LautaroEst/2016_2c_trabajo_practico-lector_de_qr/README.md

Repositorio para la documentación de proyectos de
6609/8607 Laboratorio de Microcontroladores

ESCANEO Y DECODIFICACIÓN DE UN CÓDIGO QR

En el presente proyecto se diseñará e implementará un dispositivo capaz de escanear una matriz QR impresa en una hoja de papel, decodificar el mensaje que se encuentra en ella y enviar los datos por bluetooth a un dispositivo celular. 

Integrantes: 

Estienne, Lautaro

Rebollo, Tomás
