LautaroEst/2016_2c_trabajo_practico-lector_de_qr/doc/informe/informe_corregido.pdf

# Facultad de Ingeniería - UBA Departamento de Electrónica 86.07/66.09 - Laboratorio de Microprocesadores

# Escaneo y Decodificación de Códigos QR

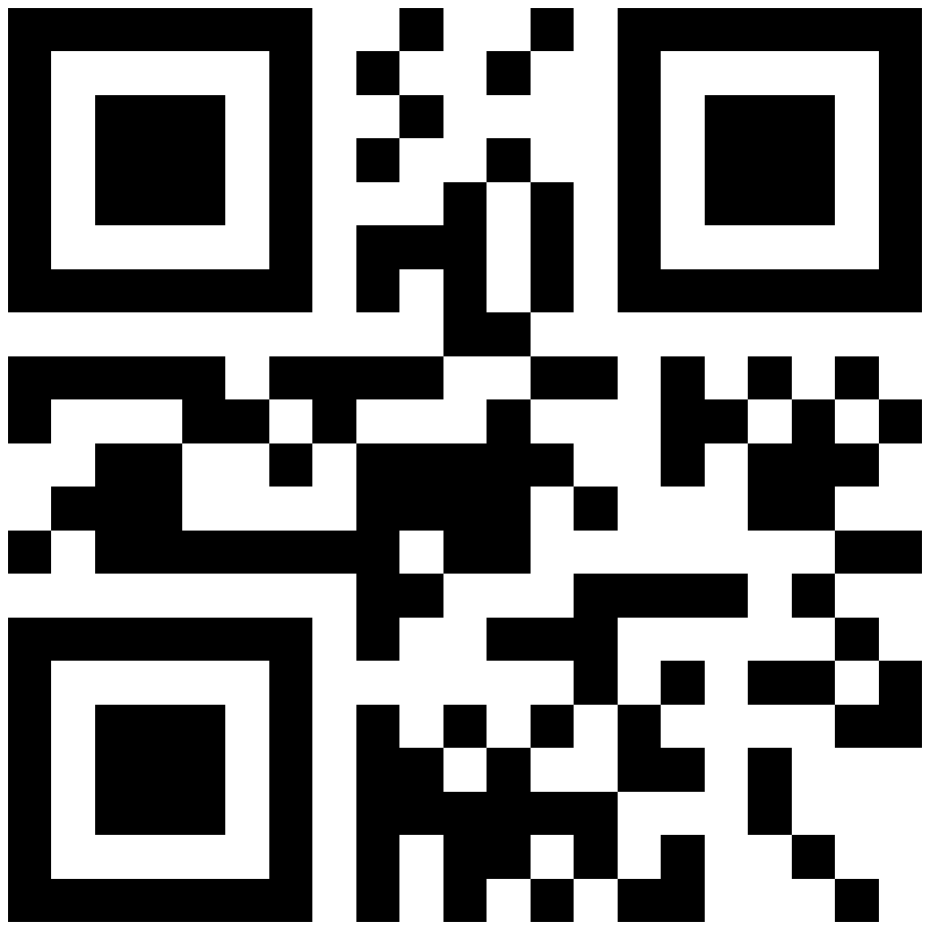
[picture p1: figure]

Profesor: | Ing. Guillermo Campiglio
Cuatrimestre/Año: | 2º/2016
Turno de las clases prácticas | Miércoles
Jefe de trabajos prácticos: | Ing. Ricardo Arias
Autores | Seguimiento del proyecto
Nombre | Apellido | Padrón
Lautaro | Estienne | 96671
Tomás | Rebollo | 90986

# Observaciones:

Fecha de aprobación | Firma J.T.P

# Coloquio Nota final Firma profesor

# 86.07/66.09 - Laboratorio de Microprocesadores do Cuatrimestre de 2016

# Estienne, Lautaro Rebollo, Tomás

# Resumen

En el presente trabajo, se construyó y programó un dispositivo capaz de escanear un código QR impreso en una hoja de papel, decodificarlo y enviar el mensaje contenido en él a un dispositivo celular. A su vez, el mismo fue diseñado para que el control de encendido y apagado del escaneo y el envío del mensaje sean controlados por Bluetooth.

# 1. Breve Introducción

Un código QR (Quick Response code, “código de respuesta rápida”) es un módulo para almacenar información

# en una matriz de puntos, que se utiliza hoy en día en distintas formas:

Registro de repuestos en el área de la fabricación de vehículos (primera implementación de estos códigos)

# Administración de inventarios en una gran variedad de industrias

# Almacenamiento de direcciones de páginas WEB en publicidades y anuncios

# Venta de productos y marketing de fidelización (como por ejemplo, cupones o descuentos)

# Etiquetado de productos en la tienda (como un código de barras)

La información que contiene un código QR puede incluír caracteres ACII, Kanji, o combinaciones de ambos, y además de los caracteres codificados, la matriz contiene una serie de puntos que dan información acerca de cómo está almacenado el mensaje en el código.

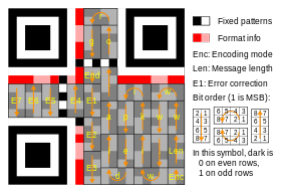
[picture p2: figure]

# Figura 1: Disposición de la información en la matriz QR

La decodificación del código consiste básicamente en dos pasos: leer y decodificar la información auxiliar de código para entender cómo está dispuesta la información, y luego leer la matriz en la forma en que está dispuesto el código (respetando la información obtenida anteriormente). En la figura 1 se muestra un código QR con el mensaje “www.wikipedia.org”, y en el mismo puede observarse qué parte del la matriz contiene la información del mensaje y qué parte contiene la información auxiliar (format info).

1

# 2. Objetivos Propuestos

La idea original del proyecto fue armar un dispositivo que permitiera escanear un código QR impreso en una hoja de papel, almacenar el mensaje contenido en él en la memoria temporal del microcontrolador, y finalmente, enviarlo a un dispositivo móvil por medio de una conexión bluetooth. También se decidió que el control de todo el proceso sea a través del mismo dispositivo.

# 3. Implementacion

Una vez propuestos los objetivos, se pasó a pensar en la forma de implementar el scanner. En primer lugar, el dispositivo debería contener un microcontrolador que se ocupe de sincronizar el proceso en su totalidad. Se sabe además que se debería constar de un sensor de luz para realizar el escaneo y a su vez, un motor que permita mover dicho sensor por la hoja. Por otro lado, la misma hoja debería ser desplazada por otro motor independiente del anterior. Por último, es necesario un circuito que se encargue de la transmisión por bluetooth (para lo cual ya existen módulos prefabricados).
Luego de algunas variantes se llegó a la versión final del dispositivo, mostrada en la figura 2:

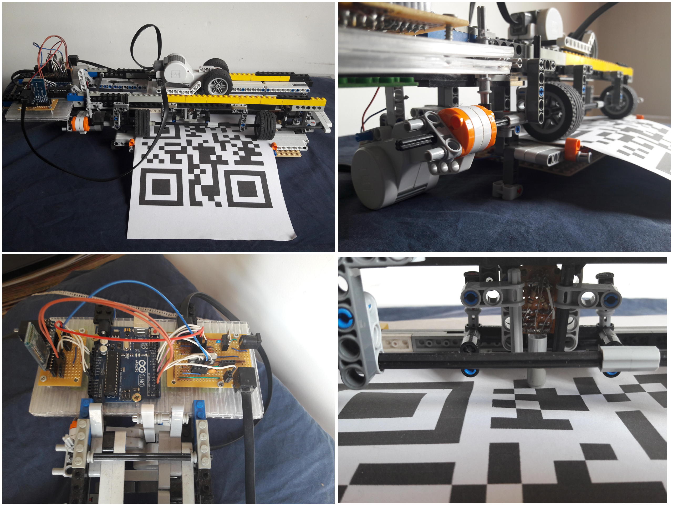
[picture p3: figure]

Figura 2: Fotografía del proyecto terminado.

2

Puede observase el código impreso en la hoja y los motores que controlan el rodillo que arrastra la hoja, y el carrito que mueve el sensor. A medida que la hoja avanza, el carrito hace recorrer al sensor por cada fila de la matriz. En cada barrido, se detectan los cambios de color y, con el dato de la posición del carrito, se calculan cuántos bits se leyeron de cada color. Como la matriz es un conjunto de puntos blancos y negros, entonces puede representarse como una serie de unos y ceros y almacenarse en la memoria temporal del micro. Una vez leído el código, el programa cargado en el microcontrolador decodifica el mensaje, almacenando en otra parte de memoria únicamente la sucesión de caracteres ASCII que componen el mensaje del código. Finalmente, el mensaje es transmitido al celular gracias al módulo bluetooth que se puede visualizar en la misma figura que antes.

Una vez pensada la forma en que el dispositivo trabajaría, se realizó el diagrama en bloques del circuito, el cual se muestra en la figura 3. Esto sirvió para definir los modelos de los materiales necesarios para el proyecto y posteriormente, la modularización del trabajo. En la siguiente sección se describe la lista de materiales y componentes utilizados en el circuito y en el resto del dispositivo.

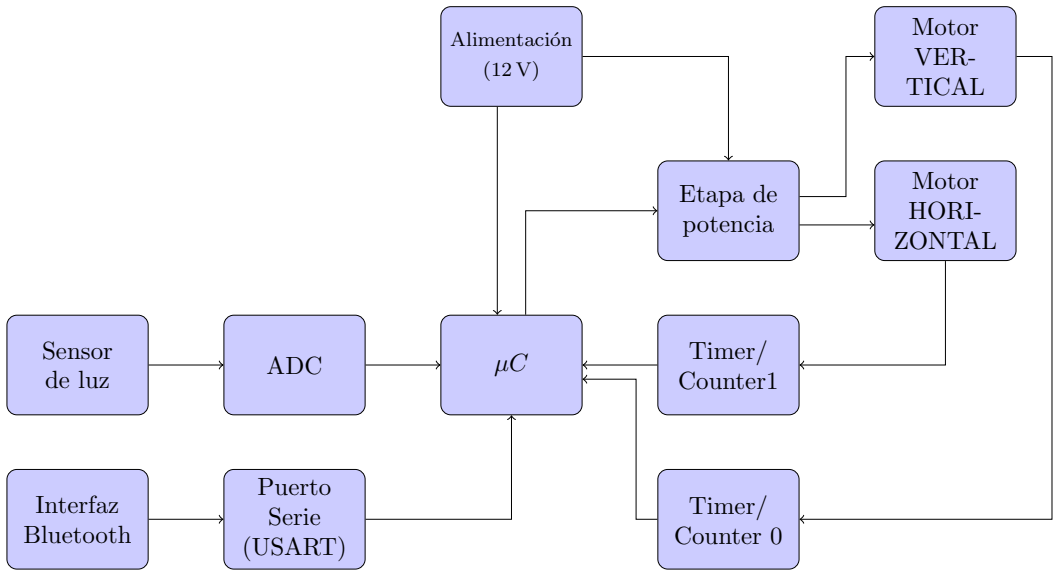
[picture p4: figure]
Alimentación; Motor VER- TICAL; Etapa de potencia; Motor HORI- ZONTAL; Sensor; de luz; ADC; Timer/; Counter1; Interfaz Bluetooth; Puerto Serie (USART); Timer/ Counter 0

Figura 3: Diagrama en bloques del circuito completo.

# 4. Descripción del Hardware

El circuito contiene una placa Arduino UNO, la cual utiliza un microcontrolador Atmega328P, que fue el implementado en este trabajo. En principio, la elección de este microcontrolador se debe fundamentalmente a la cantidad de memoria Flash y SRAM disponible, y esto es consecuencia de la gran dimensión de código que se necesitó para programar la decodificación del QR y la memoria necesaria para almacenar la matriz. Sin embargo, al finalizar el trabajo, puede comprobarse que si fuera por un tema de memoria, otros microcontroladores como el Atmega168 o el Atmega328 también habrían servido. Ahora bien, en el trabajo se utilizó la instrucción jmp para salto incondicional (debido nuevamente a la extensión del código) y esa instrucción sólo está permitida en el Atmega328P o en el Atmega168PA.
Por otro lado, se tiene el sensor de luz. El mismo fue construído específicamente para el trabajo y consiste en un circuito como el que se muestra en el esquemático del apéndice. En éste, se muestra un fotoresistor de Cadmio que varía su valor con la luz. De esta forma se obtiene una señal analogica que entra a uno de los puertos del micro y se

3

determina a partir de ella si el color que se está leyendo es blanco o negro. Para que el contraste entre un color y el otro sea mayor, se utilizó una tira de LEDs del otro lado del papel, de manera que llegue más luz a este último. Esta parte del trabajo fue, sin duda, la más crítica, ya que se debió preparar al equipo para que el escaneo soporte la resolución del código. Luego de varias pruebas se logró un resultado satisfactorio, con lo cual se concluyó que este sensor de fácil implementación sería suficiente para cubrir los objetivos del trabajo práctico.
Continuando con el circuito, se llega a la etapa de potencia utilizada para controlar los dos servo motores que controlan el escaneo. Estos motores funcionan correctamente con una tensión de 9 V, por lo que fue necesario adaptar la salida del microcontrolador con un puente-H doble (ya que se tienen dos motores). Para ello se eligió el integrado L298, uno de los más comunes para esta tarea. El circuito de esta etapa no comprende demasiadas complicaciones y se muestra en el apéndice del informe. Sí es posible agregar, sin embargo, que estos motores se comunican mendiante 6 conectores, descritos a continuación. Los primeros dos son la salida del puente-H: el motor avanza al aplicarle tensión positiva y retrocede con una tensión negativa; cuando no hay tensión, el motor se encuetra quieto. Existen por otro lado, otros dos pines destinados a la tensión de referencia del motor (VCC y GND). Finalmente, el motor cuenta con un encoder de dos terminales, el cual permite medir la velocidad con la que se mueve y la dirección en la que avanza. Para el trabajo sólo fue necesario uno de ellos, ya que sólo se midió la posición.
Por último, la interfaz del bluetooth no presenta mayores complicaciones, ya que el módulo utilizado (el HC-05 configurable como maestro-esclavo) tiene dos pines para la comunicación por puerto serie, y otros dos para la alimentación.
La construcción del dispositivo que permite sostener los motores, el sensor y el resto del circuito fue realizada mediante el equipo Mindstorms NXT 2.0 desarrollado por la empresa LEGO en 2006. El mismo viene equipado con los motores mencionados anteriormente y con todas las piezas necesarias para el armado del proyecto, excluyendo por supuesto, los componentes del circuito. La mayor parte de la información del funcionamiento de los motores fue obtenida de Wikipedia (ver referencia [6]) y de los diversos tutoriales encontrados en la web y dirigidos por personas que ya descubrieron el funcionamiento interno de los componentes.

# 5. Descripción del Software

La figura ?? muestra el diagrama de flujo del programa. Para una explicación más detallada, el código se

# encuentra dividido en 7 grandes bloques, a saber:

Inicialización y configuraciones: Dentro de este módulo se realizan todas las inicializaciones de variables y configuraciones a utilizar. Se utilizaron flags de estado y registros redefinidos con otros nombres para llevar

# más fácilmente el seguimiento del código. Las configuraciones realizadas fueron:

- Configuración de puertos como entradas y salidas.
- Configuración del ADC interno del microcontrolador.
- Configuración de timers como contadores.
- Configuración de USART como receptor de datos (el envío desde el microcontrolador será inicializado solo al momento en que se requiera enviar datos).
Una vez finalizadas las configuraciones, se realiza la primera lectura del ADC para saber en donde se encuentra actualmente el sensor.

Recepción Bluetooth: El programa quedará esperando la recepción de datos para iniciar el proceso de lectura. Se desarrolló una aplicación móvil que envía el caracter ASCII ’1’ para indicar el encendido de los motores, mientras que para desplazar la hoja verticalmente, utiliza ’+’ y ’-’.
Una vez recibido el caracter ’1’, se llama a la rutina ”leer columna”la cual se encarga de desplazar el motor horizontal para leer una línea del QR.

Movimiento de Motores: El dispositivo cuenta con dos motores, uno para realizar el barrido horizontal y leer cada columna de cuadrados, y otro para desplazar la hoja a la siguiente columna. El motor horizontal se maneja seteando los pines 6, 7 del puerto D y 0 del puerto B para retroceso o avance, y un bit de stop general

4

respectivamente. El motor vertical se maneja con los pines 2, 3 del puerto D, y 1 del puerto B. Seteando o limpiando estos bits es como se manejaron los puentes H que terminaron controlando el desplazamiento de motores. Cada motor a su vez, enviaba al microcontrolador una señal de clock mientras estuviera funcionando, para llevar un control de su desplazamiento. Esto se contabilizó utilizando los timers para lograr precisión en la lectura.

Conteo de eventos: Los enconders de los motores fueron conectados a los pines 4 y 5 del puerto D, utilizados como contadores. Los timers 0 y 1 fueron configurados en modo CTC (clear timer on compare), con clock externo en T0 y T1 respectivamente. Ambos conteos se compararon contra dos umbrales para tener dimensión de cuando se avanzaba una unidad de lo que se quería medir. Esto fue medido y seteado a partir de los valores obtenidos.

Conversión analógico digital: Se utilizaron una fotorresistencia y una tira de leds por debajo de la hoja para lograr dos umbrales de tensión bien diferenciados para cada estado (blanco y negro). A partir de esto, se midió el voltaje con el ADC para saber en que color se encontraba el sensor.
El principal problema que se encontró en la conversión, es que no se podía definir con absoluta precisión la longitud de cada cuadrado del código para saber que valor correspondía a cada instante. Para eso, se estableció una medida aproximada y se contabilizó cuanto avanzaba el carro en el mismo color, seteando un flag cada vez que este cambiaba. Así, se realizaba una división que terminaba por dar la cantidad de cuadrados leídos de cada color.
El siguiente paso fue almacenar estos valores en registros para proceder a la decodificación correspondiente de cada línea. Para eso, se utilizaron los registros R20, R21 Y R22, llenados en el orden respectivo.
Una vez finalizada cada columna, se llamaba al método ’desenmascarar’ el cual procedía a aplicar la máscara seteada por defecto y posteriormente decodificar.

Decodificación: Fueron utilizados 6 acumuladores (ACUM0, ACUM1, ACUM2, ACUM3, ACUM 4 y ACUM5) para almacenar los bits leidos en el orden decodificado correspondiente.
La decodificación fue realizada bit a bit, rolleando cada registro al carry y dependiendo de su valor y la posición del mismo, seteando bits en los acumuladores. Cabe aclarar que el código QR tiene una estructura no cien por ciento homogénea, por lo cual dependiendo de la columna que se estaba leyendo, la forma de lectura y decodificado era distinta. Para las primeras 8 columnas, dos acumuladores se llenaron cada dos columnas (ACUM1 y ACUM2), mientras que otros (los ubicados horizontalmente, ACUM 0 Y ACUM3), se llenaron cada 4. Mientras que para las restantes, fueron llenados cada dos columnas (ACUM1, ACUM2, ACUM3 y ACUM4), y cada 4 (ACUM0 y ACUM5).
Finalmente, a medida que cada acumulador era completamente llenado, se volcaba su valor en una tabla de memoria RAM en el orden correspondiente de lectura para que al finalizar, solo alcanzara con recorrer esta tabla. Para saber donde finalizaba, al terminar la lectura se agregó el caracter ’/’.
Si bien la estructura del código obligaba a un engorroso proceso de decodificado bit a bit, se pudo reutili-zar bastante código ya que al final de cuentas, eran 4 maneras distintas de recorrer los registros donde se almacenó la lectura inicial.

Envío Bluetooth: Para finalizar, se configuró al microcontrolador para enviar datos por puerto serie utilizando la interrupción de vaciado del UDRE0. A medida que se cargaban los datos, eran enviados y su valor limpiado, por lo cual la interrupción volvía a ejecutarse. A medida que esto ocurría, se incrementa-ban los punteros de la tabla para ir enviando letra a letra al dispositivo móvil. Una vez llegado al final, se inhabilitó nuevamente esta funcionalidad ya que sino queda enviando datos produciendo errores.

# Las interrupciones utilizadas fueron:

OC1Aaddr: Interrupción asociada al timer 1.

OC0Aaddr: Interrupción asociada al timer 0.

5

ADCCAddr: Interrupción asociada a la conversión analógica digital.

URXCAddr: Interrupción asociada a la recepción de datos por USART.

UDREAddr: Interrupción asociada al vaciado del UDRE0 para envío de datos.

6

Inicio | Leer ADC

## Configurar

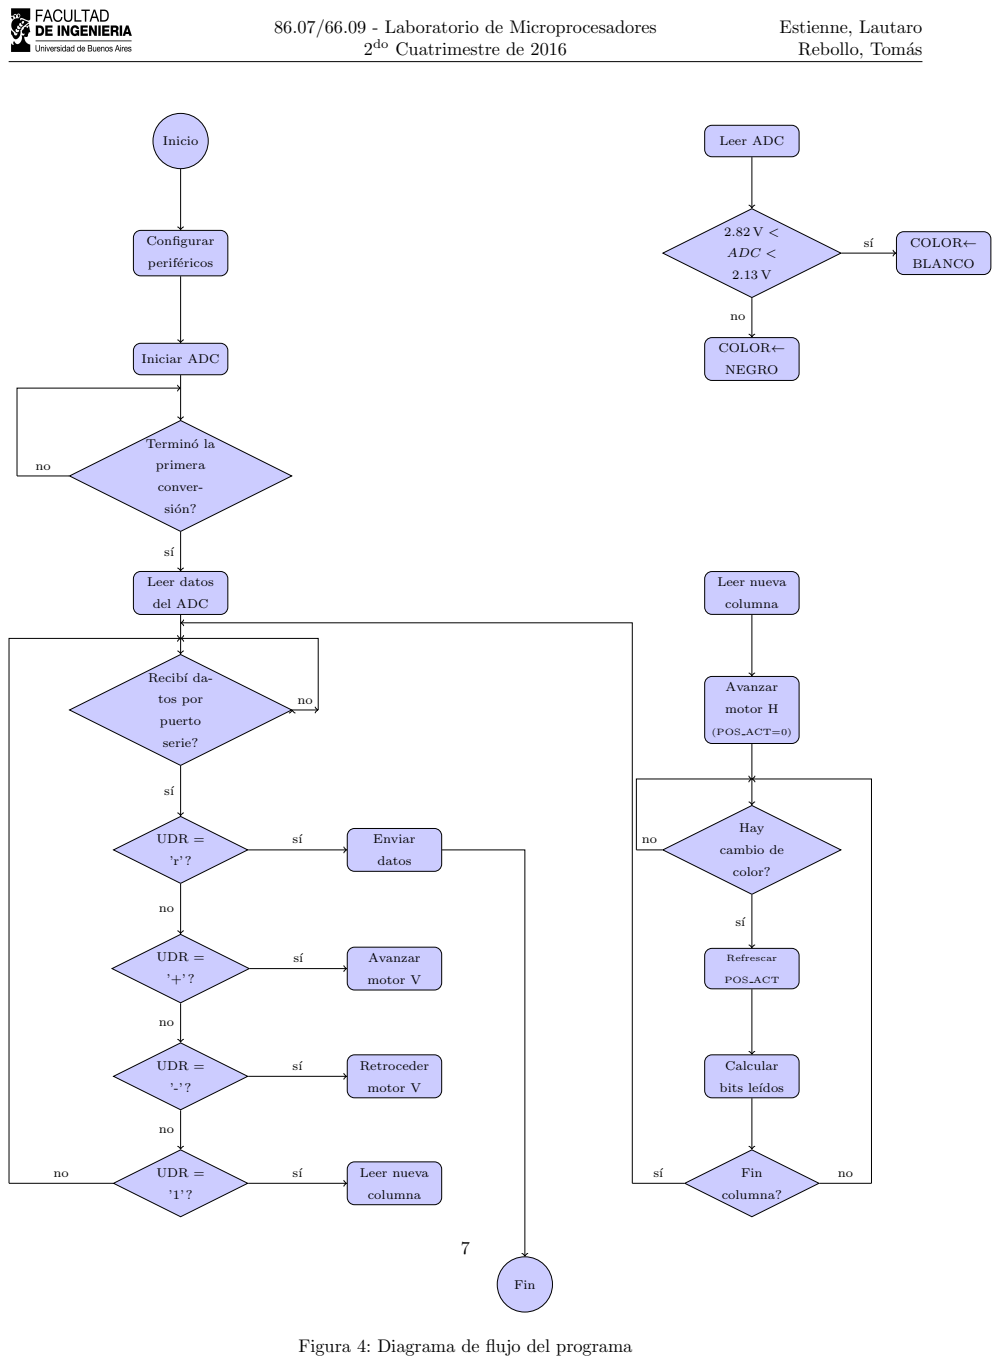
[picture p5: page 8]
periféricos; ADC <; COLOR←; BLANCO; Iniciar ADC; NEGRO; Terminó la; primera; conver-; Leer datos; del ADC; Leer nueva; columna; Recibí da-; tos por; puerto; serie?; Avanzar; motor H; (POS ACT=0); UDR =; Enviar; datos; Hay; cambio de; color?; motor V; Refrescar; POS ACT; Retroceder; Calcular; Fin; columna?

bits leídos

Figura 4: Diagrama de flujo del programa

# 6. Conclusiones y posibles mejoras

# Conclusiones:

El objetivo principal del proyecto se cumplió con éxito, y el dispositivo puede recibir, bajo ciertas limitaciones, una matriz QR impresa en una hoja de papel, guardar su contenido en la memoria del microcontrolador, procesarlo y enviar el mensaje que contiene el código a un dispositivo celular que tenga conexión por bluetooth y la aplicación adecuada. En este sentido, puede decirse que el trabajo realizado resultó muy satisfactorio, y que el objetivo de fondo que contiene la implementación de un trabajo de esta magnitud (el cual fue aprender a utilizar correctamente las herramientas del microprocesador) también se realizó con éxito.

El proyecto entregado realizaba automáticamente casi todas las funciones esperadas, menos el desplazado vertical del sensor para leer las filas de la matriz en forma continua. En lugar de ello, se decidió realizar una calibración manual (controlada por bluetooth) al finalizar cada fila. La misma consistió en controlar los motores que manejan el desplazamiento vertical de la hoja con dos nuevos botones en la aplicación móvil desarrollada para el proyecto.

El problema principal que se presentó fue que el control de motores para lograr precisión en el desplazado requería de más horas de trabajo y pruebas para poder calibrar la funcionalidad. Además, la estructura del dispositivo para mantener la hoja centrada y fijada era un poco endeble, lo cual terminaba provocando que los desplazamientos verticales fueran siempre distintos, no pudiendo normalizarlo a una sola medida.

Por otra parte, fue posible realizar el escaneo para un solo tamaño del código, ya que la distinción entre puntos blancos y negros implicaba tener conocimiento previo del ancho de cada punto. Esto se hizo a modo de simplificación y con el objetivo de acotar la complejidad del programa y las posibles fallas.

Junto con la programación necesaria para utilizar las herramientas del micro, también se realizaron diversas tareas de hardware que permitieron ampliar nuestros conocimientos sobre la electrónica.

Luego de finalizar el proyecto, pudimos tomar noción de qué tan importante es la planificación y el conocimiento de lo que se va a hacer y cómo, ya que esto permite saber cuánto tiempo insumir en cada tarea y darle margen a los errores que se presentarán para poder resolverlos. Además, se entendió que existe la posibilidad de que una mala decisión al principio, afecte el desarrollo del proyecto, produciendo así que los tiempos no alcancen y no se logre cumplir el objetivo. El trabajo en equipo y la división de tareas al inicio fue fundamental para ir avanzando, ya que nos resultaba muy difícil juntarnos con frecuencia. Así, cada uno avanzó en las tareas correspondientes, logrando que los tiempos alcanzaran al final del cuatrimestre.

# Posibles mejoras a realizar:

La mejora fundamental que podría realizarse es la de automatizar completamente el proceso de lectura, logrando que el motor vertical dé pequeños saltos de manera constante sin desplazarse por demás o mover la hoja. Para ello, debería comprobarse su comportamiento con un motor paso a paso en lugar del utilizado. Además, podría implementarse la técnica del PWM para avanzar el motor horizontal. Este método no se consideró en los planes originales ya que, en un principio, la acción del motor para recorrer una fila se limita a avanzar el motor con una única velocidad. Además, utilizar este método hace que sea mucho más complejo el proceso de identificación de cada punto.

Consideramos que sea posible mejorar la parte del programa que se encarga de la decodificación implementando una forma de almacenamiento por filas y un código hecho en C. Esto facilitaría la programación y daría la posiblidad de utilizar diferentes tipos de lectura, pero con la desventaja de que sería necesario más memoria para contener el código y las filas escaneados. Debe mencionarse que utilizar Assembler para la decodificación, siempre implica analizar bit a bit la situación, por lo cual no es posible reemplazarlo por algo que no sea engorroso de programar.

8

El circuito que controlaba los motores y la tira de leds podría ser reemplazado por algo más pequeño y que realice un menor consumo de energía, ya que notamos que el regulador de tensión aumentaba bastante su temperatura, teniendo que apagar el dispositivo cada vez que se terminaba de utilizar o colocando un disipador.

Otra cosa que se podría mejorar, es un algoritmo de control para saber cuándo es necesario realizar nuevamente la lectura de datos.

# 7. Código

1
2 | ; ∗ ∗ ∗ ∗ ∗ ∗ ∗ ∗ ∗ ∗ ∗ ∗ ∗ ∗ ∗ ∗ ∗ ∗ ∗ ∗ ∗ ∗ ∗ ∗ ∗ ∗ ∗ ∗ ∗ ∗ ∗ ∗ ∗ ∗ ∗ ∗ ∗ ∗ ∗ ∗ ∗ ∗ ∗ ∗ ∗ ∗ ∗ ∗ ∗ ∗ ∗ ∗ ∗ ∗ ∗ ∗ ∗ ∗ ∗ ∗ ∗ ∗ ∗ ∗;
3 | ; PROYECTO FINAL : ESCANEO, DECODIFICACIOŃ Y ENVÍO DE UN CO´DIGO QR
4 | ; ∗ ∗ ∗ ∗ ∗ ∗ ∗ ∗ ∗ ∗ ∗ ∗ ∗ ∗ ∗ ∗ ∗ ∗ ∗ ∗ ∗ ∗ ∗ ∗ ∗ ∗ ∗ ∗ ∗ ∗ ∗ ∗ ∗ ∗ ∗ ∗ ∗ ∗ ∗ ∗ ∗ ∗ ∗ ∗ ∗ ∗ ∗ ∗ ∗ ∗ ∗ ∗ ∗ ∗ ∗ ∗ ∗ ∗ ∗ ∗ ∗ ∗ ∗ ∗;
5
6
7
8
9 | ; ∗ ∗ ∗ ∗ ∗ ∗ ∗ ∗ ∗ ∗ ∗ ∗ ∗ ∗ ∗ ∗ ∗ ∗ ∗ ∗ ∗ ∗ ∗ ∗ ∗ ∗ ∗ ∗ ∗ ∗ ∗ ∗ ∗ ∗ ∗ ∗ ∗ ∗ ∗ ∗ ∗ ∗ ∗ ∗ ∗ ∗ ∗ ∗ ∗ ∗ ∗ ∗ ∗ ∗ ∗ ∗ ∗ ∗ ∗ ∗ ∗ ∗ ∗ ∗ ∗ ∗ ∗ ∗ ∗ ∗ ∗ ∗ ∗ ∗ ∗ ∗ ∗ ∗ ∗ ∗ ∗ ∗ ∗ ∗ ∗ ∗ ∗ ∗ ∗ ∗ ∗ ∗ ∗ ;
10 | ;BLOQUE DE DEFINICIONES
11
12 | . i n c l u d e | ” m 3 2 8P d e f . i n c ”
13 | . i n c l u d e | ” m a c r o s . i n c ”
14
15 | ; ; ; | SE DEFINE UN REGISTRO DE I /O, | ”SCANNER” , CON LOS FLAGS NECESARIOS PARA EL ESCANEO
16 | . e q u | SCANNER = GPIOR0
17 | . e q u | COLOR = 0 | ; | Negro=1 , B lanco=0
18 | . e q u | ESCANEANDO = 1 | ; | F lag pa ra | l a | c o n v e r s i ón d e l ADC
19 | . e q u | CAMBIO COLOR = 2 | ; | F lag pa ra | e l | c á l c u l o | de | l o s | b i t s | l e í do s
20 | . e q u | FIN COLUMNA = 3
21 | . e q u | AVANZO CASILLA = 4
22 | . e q u | FLAG BLUETOOTH = 5 | ; F l a g s | pa ra | l a | r e c e p c i ón po r | b l u e t o o t h
23 | . e q u | FLAG BLUETOOTH VACIO = 6
24
25 | ; ; ; | SE DEFINE UN REGISTRO, | ”MOTORES” , CON LOS FLAGS NECESARIOS PARA VIGILAR EL ESTADO DE LOS MOTORES
26 | . d e f | MOTORES = r 3 1
27 | . e q u | MOTOR H ENABLE = 0
28 | . e q u | MOTOR H STOP FLAG = 1
29 | . e q u | MOTOR H DIR = 2 | ; DIR=FORWARD=1 , DIR=REVERSE=0
30 | . e q u | MOTOR V ENABLE = 3
31 | . e q u | MOTOR V STOP FLAG = 4
32 | . e q u | MOTOR V DIR = 5
33
34 | ; ; ; REGISTROS Y CONSTANTES PERSONALIZADOS
35 | . e q u | LIMITE FLANCOS = 255 | ;Número de | f l a n c o s | que c o r r e s p o n d e n | a l | t iempo que
36 | ; t a r d a | e l | motor | H o r i z o n t a l | en | r e c o r r e r | e l | ancho de | l a pá g i n a
37 | . e q u | TAMANIO CASILLA = 13 | ;Número de | f l a n c o s | que c o r r e s p o n d e n | a l | l a r g o | de una | c a s i l l a
38 | . e q u | CORTE POR REDONDEO = TAMANIO CASILLA − 9
39 | . e q u | CANTIDAD FILAS = 21
40 | . e q u | CANTIDAD COLUMNAS = 21
41 | . e q u | ULTIMO BIT DE FILA = CANTIDAD COLUMNAS − 1
42 | . e q u | ULTIMO BIT DE COLUMNA = CANTIDAD FILAS − 1
43 | . e q u | BAUD RATE = 0 x67 | ; E s t e | e s | e l | v a l o r | que debe | p o n e r s e | pa ra | t e n e r un baud r a t e | de 9 6 0 0 , que | e s | e l | que u sa | e l | hc 05 .
44 | . e q u | CARACTER FIN = ’ / ’ | ; C a r a c t e r | con | e l | que t e rm i n a r á | e l | c ó d i g o QR
45 | . e q u | INICIO TABLA = 0 x0100
46
47 | . d e f | CERO = r 0 | ; R e g i s t r o s | u t i l i z a d o s | pa ra una p rueba de env í o
48 | . d e f | UNO = r 1
49 | . d e f | CANT = r 3 | ; Can t idad de | b i t s | l e í do s | d e l mismo c o l o r
50 | . d e f | SIZE = r 4 | ; R e g i s t r o | que gua rda | e l | tamaño de un b i t
51 | . d e f | SIZE 2 = r 5
52
53 | . d e f | rtemp1 = r 1 6 | ; R e g i s t r o s | a u x i l i a r e s
54 | . d e f | rtemp2 = r 1 7
55 | . d e f | BIT ACTUAL = r 1 8 | ; P o s i c i ón a c t u a l | d e l | motor en una co l um na .
56 | . d e f | POS INICIAL = r 8 | ; E s t o s | do s | r e g i s t r o s | s i r v e n | pa ra | c a l c u l a r | l a | c a n t i d a d de | b i t s | que | s e | l e y e r o n | d e l mismo c o l o r
57 | . d e f | POS FINAL = r 9
58
59 | ; ; ; REGISTROS PARA LA DECODIFICACIOŃ
60 | . d e f | CONT H = r 1 9 | ; Cuenta | l a | c a n t i d a d de co lumna s | l e í da s
61 | . d e f | CANT LETRAS LEIDAS = r 6 | ; Cuenta | l a | c a n t i d a d de | l e t r a s | d e c o d i f i c a d a s
62 | . d e f | LENGTH = r 7
63 | . d e f | ACUM1 = r 2 3 | ; La i d e a | de | e s t o s | a c um u la do r e s | e s | i r | s o s t e n i e n d o | l o s | v a l o r e s | ya p r o c e s a d o s , | que | l u e g o | s e | gua rdan en SRAM
64 | . d e f | ACUM2 = r 2 4
65 | . d e f | ACUM3 = r 2 5
66 | . d e f | ACUM4 = r 2 8
67 | . d e f | ACUM5 = r 2 9
68 | . d e f | ACUM6 = r 3 0
69
70 | . e q u | B7 = 0 x80
71 | . e q u | B6 = 0 x40
72 | . e q u | B5 = 0 x20
73 | . e q u | B4 = 0 x10
74 | . e q u | B3 = 0 x08
75 | . e q u | B2 = 0 x04
76 | . e q u | B1 = 0 x02
77 | . e q u | B0 = 0 x01

9

78
79 | ; ; ; | DEFINICIOŃ DE LOS PUERTOS
80 | . e q u | MOTOR H OUT1 PORT DIR = DDRD | ; Mo to re s HORIZONTAL y VERTICAL.
81 | . e q u | MOTOR H OUT1 PORT = PORTD | ; Cada motor | t i e n e | do s | p i n e s | (OUT1 y OUT2) que | c o n t r o l a n | l a
82 | . e q u | MOTOR H OUT1 PIN = 6 | ; su mov im iento :
83 | . e q u | MOTOR H OUT2 PORT DIR = DDRD | ; | f o rw a r d −−> OUT1=0 , OUTT2=1
84 | . e q u | MOTOR H OUT2 PORT = PORTD | ; | r e v e r s e −−> OUT1=1 , OUT2=0
85 | . e q u | MOTOR H OUT2 PIN = 7 | ; | s t o p | −−> OUT1=0 , OUT2=0
86 | . e q u | MOTOR H ENABLE PORT DIR = DDRB | ; Además , | cada motor | t i e n e un ENABLE que | h a b i l i t a | su | f u n c i o n am i e n t o .
87 | . e q u | MOTOR H ENABLE PORT = PORTB
88 | . e q u | MOTOR H ENABLE PIN = 0
89 | . e q u | MOTOR V OUT1 PORT DIR = DDRD
90 | . e q u | MOTOR V OUT1 PORT = PORTD
91 | . e q u | MOTOR V OUT1 PIN = 2
92 | . e q u | MOTOR V OUT2 PORT DIR = DDRD
93 | . e q u | MOTOR V OUT2 PORT = PORTD
94 | . e q u | MOTOR V OUT2 PIN = 3
95 | . e q u | MOTOR V ENABLE PORT DIR = DDRB
96 | . e q u | MOTOR V ENABLE PORT = PORTB
97 | . e q u | MOTOR V ENABLE PIN = 1
98
99 | . e q u | COUNTER0 PORT DIR = DDRD | ; C o n f i g u r a c i ón de | l o s | p u e r t o s | u t i l i z a d o s | como c o n t a d o r e s | e x t e r n o s ,
100 | . e q u | COUNTER0 PIN = 4 | ; c o n e c t a d o s a | l o s | e n c o d e r s | d e l | mo to r s
101 | . e q u | COUNTER1 PORT DIR = DDRD
102 | . e q u | COUNTER1 PIN = 5
103
104 | . e q u | SENSOR INPUT PORT DIR = DDRC | ; En t rada | a n a l ó g i c a | d e l | s e n s o r | de | l u z .
105 | . e q u | SENSOR INPUT PIN = 1
106
107 | . e q u | SENSOR LED PORT DIR = DDRC | ; Led que | v i e n e | con | e l | s e n s o r . No f u e | n e c e s a r i o | su | u t i l i z a c i ón ,
108 | . e q u | SENSOR LED PORT = PORTC | ; p e r o | s e | c o n f u g u r a | pa ra | m a n t e n e r l o | a p a g a d o .
109 | . e q u | SENSOR LED PIN = 0
110
111 | . e q u | LED PRUEBA PORT DIR = | DDRB | ; Led de prueba , | de | l a | p l a c a | de Ardu ino UNO.
112 | . e q u | LED PRUEBA PORT | = | PORTB
113 | . e q u | LED PRUEBA PIN | = | 5
114
115
116
117 | ; ∗ ∗ ∗ ∗ ∗ ∗ ∗ ∗ ∗ ∗ ∗ ∗ ∗ ∗ ∗ ∗ ∗ ∗ ∗ ∗ ∗ ∗ ∗ ∗ ∗ ∗ ∗ ∗ ∗ ∗ ∗ ∗ ∗ ∗ ∗ ∗ ∗ ∗ ∗ ∗ ∗ ∗ ∗ ∗ ∗ ∗ ∗ ∗ ∗ ∗ ∗ ∗ ∗ ∗ ∗ ∗ ∗ ∗ ∗ ∗ ∗ ∗ ∗ ∗ ∗ ∗ ∗ ∗ ∗ ∗ ∗ ∗ ∗ ∗ ∗ ∗ ∗ ∗ ∗ ∗ ∗ ∗ ∗ ∗ ∗ ∗ ∗ ∗ ∗ ∗ ∗ ∗ ∗ ;
118 | ;COMIENZO DEL PROGRAMA
119
120 | ; ; | Tab la de | i n t e r r u p c i o n e s
121 | . o r g 0 x0000
122 | rjmp | i n i c i o
123 | . o r g OC1Aaddr
124 | rjmp | c o u n t e r 1 i n t h a n d l e r
125 | . o r g OC0Aaddr
126 | rjmp | c o u n t e r 0 i n t h a n d l e r
127 | . o r g ADCCaddr
128 | rjmp | a d c i n t h a n d l e r
129 | . o r g URXCaddr
130 | rjmp | u r x i n t h a n d l e r | ; I n t e r r u p c i ón p r o d u c i d a | po r | l a | r e c e p c i ón de d a t o s
131 | . o r g UDREaddr
132 | rjmp | u d r e i n t h a n d l e r
133 | . o r g INT VECTORS SIZE
134
135
136 | i n i c i o :
137 | ; ; | C o n f i g u r a c i o n e s | v a r i a s | ( v e r | s e c c i ón ”FUNCIONES DE CONFIGURACIOŃ” )
138 | l d i | rtemp1 ,HIGH(RAMEND)
139 | ou t sph , rtemp1
140 | l d i | rtemp1 ,LOW(RAMEND)
141 | ou t | s p l , rtemp1
142 | r c a l l | c o n f i g u r a r p u e r t o s
143 | r c a l l | c o n f i g u r a r a d c
144 | r c a l l | c o n f i g u r a r c o n t a d o r e s
145 | ; ; | I n i c i a l i z a c i ón de | l o s | r e g i s t r o s | que | s e van a | u t i l i z a r
146 | i n i c i a l i z a c i o n r e g i s t r o s :
147 | l d i XL , LOW( INICIO TABLA ) | ; Pun te ro a | l a | t a b l a | donde s e | gua rda | e l | c ó d i g o
148 | l d i XH, HIGH( INICIO TABLA )
149 | l d i | rtemp1 , ’ 0 ’ | ; A s c i i | pa ra | c e r o y uno ( E s to | s e | u t i l i z ó pa ra una p rueba de | l e c t u r a y env í o )
150 | mov CERO, rtemp1
151 | l d i | rtemp1 , ’ 1 ’
152 | mov UNO, rtemp1
153 | l d i | rtemp1 , TAMANIO CASILLA | ; E s to | s e | u sa de spu é s | pa ra | c a l c u l a r | l o s | b i t s | e s c a n e a d o s . | Ver ” c a l c u l a r b i t s l e i d o s ” .
154 | mov SIZE , rtemp1
155 | l d i | rtemp1 ,CORTE POR REDONDEO
156 | mov SIZE 2 , rtemp1
157 | e o r | r20 , r 2 0 | ; R e g i s t r o s | v a r i o s | que | s e | usan en | e l | e s c a n e o . | r20 , | r 2 1 y r 2 2 | s e | usan
158 | e o r | r21 , r 2 1 | ; pa ra | g u a r d a r | l o s | b i t s | de cada co l um na .
159 | e o r | r22 , r 2 2
160 | e o r CONT H,CONT H
161 | e o r BIT ACTUAL , BIT ACTUAL
162 | e o r CANT,CANT
163 | c b i SCANNER,FLAG BLUETOOTH | ; F l a g s | v a r i o s
164 | c b i SCANNER, AVANZO CASILLA
165 | c b i SCANNER,FIN COLUMNA
166 | e o r ACUM1, ACUM1 | ; R e g i s t r o s | pa ra | l a | d e c o d i f i c a c i ón
167 | e o r ACUM2, ACUM2
168 | e o r ACUM3, ACUM3
169 | e o r ACUM4, ACUM4
170 | e o r ACUM5, ACUM5
171 | e o r ACUM6, ACUM6
172 | l d i | rtemp1 , 0 x00
173 | mov CANT LETRAS LEIDAS , | rtemp1
174 | l d i | rtemp1 , 0 x1A
175 | mov LENGTH, | rtemp1 | ; I n i c i a l i z o | e l | v a l o r | de | l e n g t h | con | l a mayor c a n t i d a d de d a t o s que puedo | l l e g a r | a | l e e r .

10

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

11

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

12

373 | ; ; | Func i ón de | c o n f i g u r a c i ón de | l o s | t im e r s / c o n t a d o r e s .
374 | c o n f i g u r a r c o n t a d o r e s :
375 | r c a l l | c o n f i g t i m e r 1
376 | r c a l l | c o n f i g t i m e r 0
377 | r e t
378 | c o n f i g t i m e r 1 :
379 | push rtemp1
380 | l d i | rtemp1 ,HIGH(LIMITE FLANCOS )
381 | s t s OCR1AH, rtemp1
382 | l d i | rtemp1 ,LOW(LIMITE FLANCOS )
383 | s t s OCR1AL, rtemp1
384 | l d i | rtemp1 , 0
385 | s t s TCCR1A, rtemp1
386 | l d i | rtemp1 ,(1<<WGM12) |(1<<CS12 ) |(1<<CS11 ) |(1<<CS10 ) | ; C o n f i g u r a d o en modo CTC, | con | c l o c k | e x t e r n o | en T1
387 | s t s TCCR1B, rtemp1
388 | l d i | rtemp1 ,(1<<OCIE1A ) | ; H a b i l i t a r | i n t e r r u p c i o n e s
389 | s t s TIMSK1 , rtemp1
390 | l d i | rtemp1 ,(1<<OCF1A)
391 | ou t TIFR1 , rtemp1
392 | pop rtemp1
393 | r e t
394 | c o n f i g t i m e r 0 :
395 | push rtemp1
396 | l d i | rtemp1 , 2
397 | ou t OCR0A, rtemp1
398 | l d i | rtemp1 ,(1<<WGM01)
399 | ou t TCCR0A, rtemp1
400 | l d i | rtemp1 ,(1<<CS02 ) |(1<<CS01 ) |(1<<CS00 ) | ; C o n f i g u r a d o en modo CTC, | con | c l o c k | e x t e r n o en T0
401 | ou t TCCR0B, rtemp1
402 | l d i | rtemp1 ,(1<<OCIE0A ) | ; H a b i l i t a r | i n t e r r u p c i o n e s
403 | s t s TIMSK0 , rtemp1
404 | l d i | rtemp1 ,(1<<OCF0A)
405 | ou t TIFR0 , rtemp1
406 | pop rtemp1
407 | r e t
408
409 | ; ; | Manejo de | l a s | i n t e r r u p c i o n e s
410 | a d c i n t h a n d l e r :
411 | c b i SCANNER,ESCANEANDO
412 | r e t i
413 | c o u n t e r 1 i n t h a n d l e r :
414 | s b i SCANNER,FIN COLUMNA
415 | r e t i
416 | c o u n t e r 0 i n t h a n d l e r :
417 | s b i SCANNER,AVANZO CASILLA
418 | r e t i
419 | u d r e i n t h a n d l e r :
420 | s b i SCANNER,FLAG BLUETOOTH VACIO
421 | r e t i
422 | u r x i n t h a n d l e r :
423 | s b i SCANNER,FLAG BLUETOOTH
424 | r e t i
425
426 | ; ∗ ∗ ∗ ∗ ∗ ∗ ∗ ∗ ∗ ∗ ∗ ∗ ∗ ∗ ∗ ∗ ∗ ∗ ∗ ∗ ∗ ∗ ∗ ∗ ∗ ∗ ∗ ∗ ∗ ∗ ∗ ∗ ∗ ∗ ∗ ∗ ∗ ∗ ∗ ∗ ∗ ∗ ∗ ∗ ∗ ∗ ∗ ∗ ∗ ∗ ∗ ∗ ∗ ∗ ∗ ∗ ∗ ∗ ∗ ∗ ∗ ∗ ∗ ∗ ∗ ∗ ∗ ∗ ∗ ∗ ∗ ∗ ∗ ∗ ∗ ∗ ∗ ∗ ∗ ∗ ∗ ∗ ∗ ∗ ∗ ∗ ∗ ∗ ∗ ∗ ∗ ∗ ∗ ;
427 | ; FUNCIONES AUXILIARES
428
429 | ; ; | Ru t ina de d e l a y usando | e l | Timer2
430 | d e l a y :
431 | push rtemp2
432 | e o r rtemp2 , rtemp2
433 | l o o p d e l a y :
434 | r c a l l | d e l a y t im e r 2
435 | i n c | rtemp2
436 | c p i | rtemp2 , 3
437 | b rne | l o o p d e l a y
438 | pop rtemp2
439 | r e t
440 | d e l a y t im e r 2 :
441 | push rtemp1
442 | l d i | rtemp1 , 0
443 | s t s TCNT2, | rtemp1 | ; Va lo r | i n i c i a l
444 | l d i | rtemp1 , 1 0 0
445 | s t s OCR2A, rtemp1 | ; Umbral
446 | l d i | rtemp1 ,(1<<WGM21)
447 | s t s TCCR2A, rtemp1 | ; Modo CTC
448 | l d i | rtemp1 ,(1<<CS22 ) |(1<<CS21 ) |(1<<CS20 )
449 | s t s TCCR2B, rtemp1
450 | a g a i n :
451 | i n rtemp1 , TIFR2
452 | s b r s | rtemp1 ,OCF2A
453 | rjmp a g a i n
454 | l d i | rtemp1 , 0 | ; D e t e n e r Timer
455 | s t s TCCR2B, rtemp1
456 | l d i | rtemp1 ,(1<<OCF2A)
457 | ou t TIFR2 , rtemp1
458 | pop rtemp1
459 | r e t
460
461 | ; ; | F u n c i o n e s | pa ra | c o n t r o l a r | l o s | mo to r e s
462 | mo to r A fo rwa r d :
463 | c b i MOTOR H OUT1 PORT,MOTOR H OUT1 PIN
464 | s b i MOTOR H OUT2 PORT,MOTOR H OUT2 PIN
465 | s b r MOTORES,1<<MOTOR H DIR
466 | c b r MOTORES,1<<MOTOR H STOP FLAG
467 | r e t
468 | m o t o r A s t o p :
469 | c b i MOTOR H OUT1 PORT,MOTOR H OUT1 PIN
470 | c b i MOTOR H OUT2 PORT,MOTOR H OUT2 PIN
471 | s b r MOTORES,1<<MOTOR H STOP FLAG

13

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

14

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

15

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

16

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

17

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

18

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

19

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

20

1159 | ST X+ , R14
1160 | EOR ACUM2, ACUM2
1161 | INC CANT LETRAS LEIDAS
1162 | RET
1163 | ; Guarda ACUM3 en SRAM, | l o | l im p i a | e i n c r em e n t a | l a | c a n t i d a d de | l e t r a s | l e i d a s .
1164 | guardo acum3 :
1165 | MOV R14 , ACUM3
1166 | ST X+ , R14
1167 | EOR ACUM3, ACUM3
1168 | INC CANT LETRAS LEIDAS
1169 | RET
1170 | ; Guarda ACUM4 en SRAM, | l o | l im p i a | e i n c r em e n t a | l a | c a n t i d a d de | l e t r a s | l e i d a s .
1171 | guardo acum4 :
1172 | MOV R14 , ACUM4
1173 | ST X+ , R14
1174 | EOR ACUM4, ACUM4
1175 | INC CANT LETRAS LEIDAS
1176 | RET
1177 | ; Guarda ACUM5 en SRAM, | l o | l im p i a | e i n c r em e n t a | l a | c a n t i d a d de | l e t r a s | l e i d a s .
1178 | guardo acum5 :
1179 | MOV R14 , ACUM5
1180 | ST X+ , R14
1181 | EOR ACUM5, ACUM5
1182 | INC CANT LETRAS LEIDAS
1183 | RET
1184 | ; Guarda ACUM6 en SRAM, | l o | l im p i a | e i n c r em e n t a | l a | c a n t i d a d de | l e t r a s | l e i d a s .
1185 | guardo acum6 :
1186 | MOV R14 , ACUM6
1187 | ST X+ , R14
1188 | EOR ACUM6, ACUM6
1189 | INC CANT LETRAS LEIDAS
1190 | RET

# Referencias

[1] Muhammad Ali Mazidi, Zarmad Naimi, Sepehr Naimi. The AVR Microcontroller and Embedded System Using Assembly and C. Prentice Hall.
[2] Atmel 8-bit Microcontroller 4/8/16/32Kbytes In-system Programmable Flash Datasheet.

# [3] Atmel AVR 8-bit Instruction Set Manual

# [4] https://en.wikipedia.org/wiki/QRcode

# [5] http://www.ams.org/samplings/feature-column/fc-2013-02

# [6] https://en.wikipedia.org/wiki/Lego_Mindstorms_NXT

# Apéndice

A continuación se muestran los esquemáticos de la placa de Arduino UNO y del circuito diseñado para la implementación del escaneo.

21

# Arduino UNO Reference Design

TM

Reference Designs ARE PROVIDED "AS IS" AND "WITH ALL FAULTS". Arduino DISCLAIMS ALL OTHER WARRANTIES, EXPRESS OR IMPLIED, Arduino may make changes to specifications and product descriptions at any time, without notice. The Customer must not REGARDING PRODUCTS, INCLUDING BUT NOT LIMITED TO, ANY IMPLIED WARRANTIES OF MERCHANTABILITY OR FITNESS FOR A PARTICULAR PURPOSE

rely on the absence or characteristics of any features or instructions marked "reserved" or "undefined." Arduino reserves

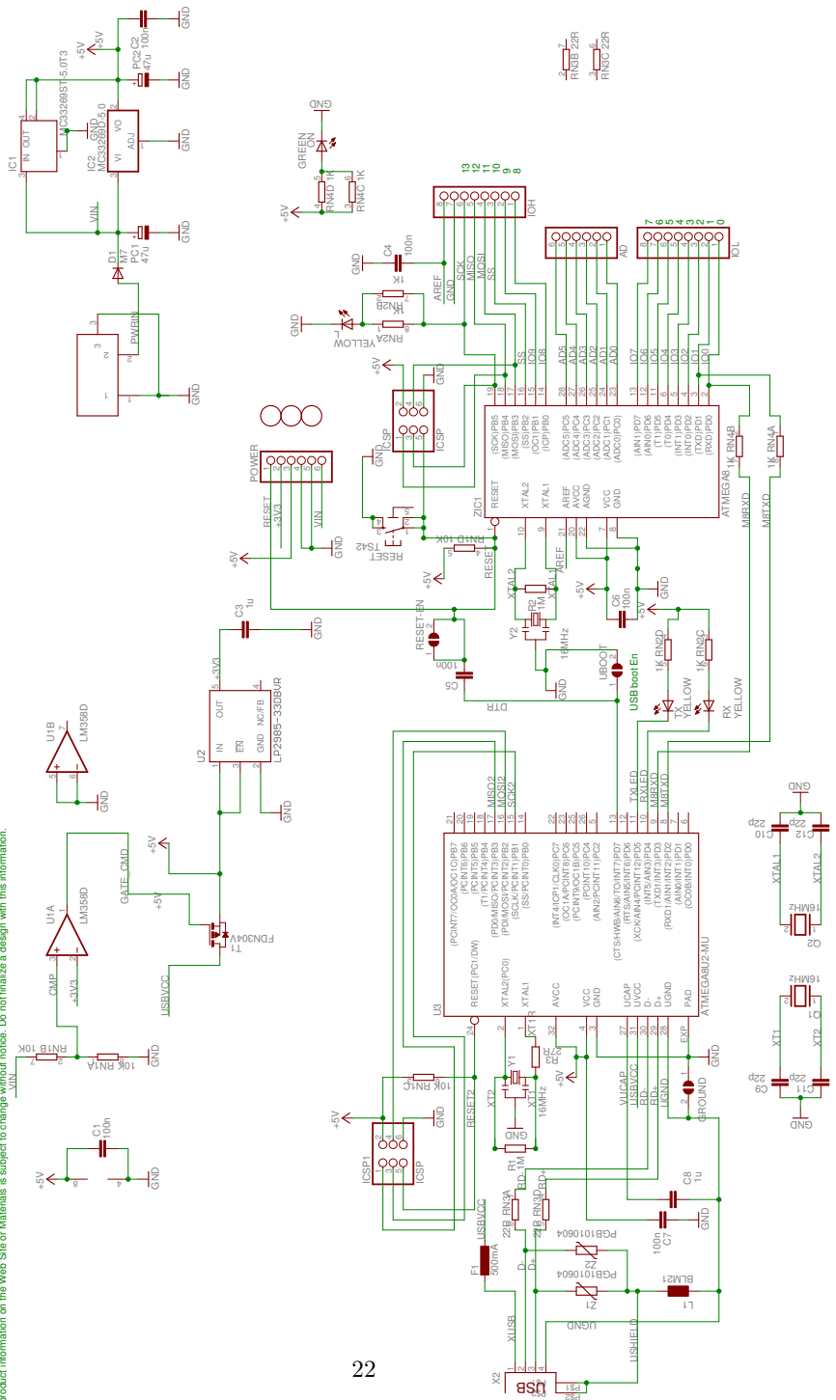
[picture p6: figure]
ATMEGA8; ICSP; +5V GND; GND; 100nGND 47u 47u GND GND; GND GREEN; YELLOW; M7 GND MC33269D-5.0 MC33269ST-5.0T3; 100n GND; GWOLLEY ND; +5V LM358D LM358D GND GND; ATMEGA8U2-MU; 16MHz 16MHz DNG; (ADC5)PC5; (ADC4)PC4; (ADC3)PC3; (ADC2)PC2; (ADC1)PC1; (ADC0)PC0) 23; (SCK)PB5; (MISO)PB4; (MOSI)PB3; (ICP)PB0; (AIN1)PD7; (AIN0)PD6; (INT1)PD3; (INT0)PD2; (TXD)PD1; (RXD)PD0; GND 8 VCC; 7 AVCC 20 AREF; 21 XTAL1; 9 XTAL2; 10 RESET; AGND; ZIC1; IOL; IOH; IC2 ADJ; 3 OUT; 6 POWER; (PCINT9/OC1B)PC5; (PCINT10)PC4; (INT4/ICP1/CLK0)PC7; (OC1A/PCINT8)PC6; (AIN2/PCINT11)PC2; (PCINT5)PB5; (T1/PCINT4)PB4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

these for future definition and shall have no responsibility whatsoever for conflicts or incompatibilities arising from future changes to them. The product information on the Web Site or Materials is subject to change without notice. Do not finalize a design with this information.

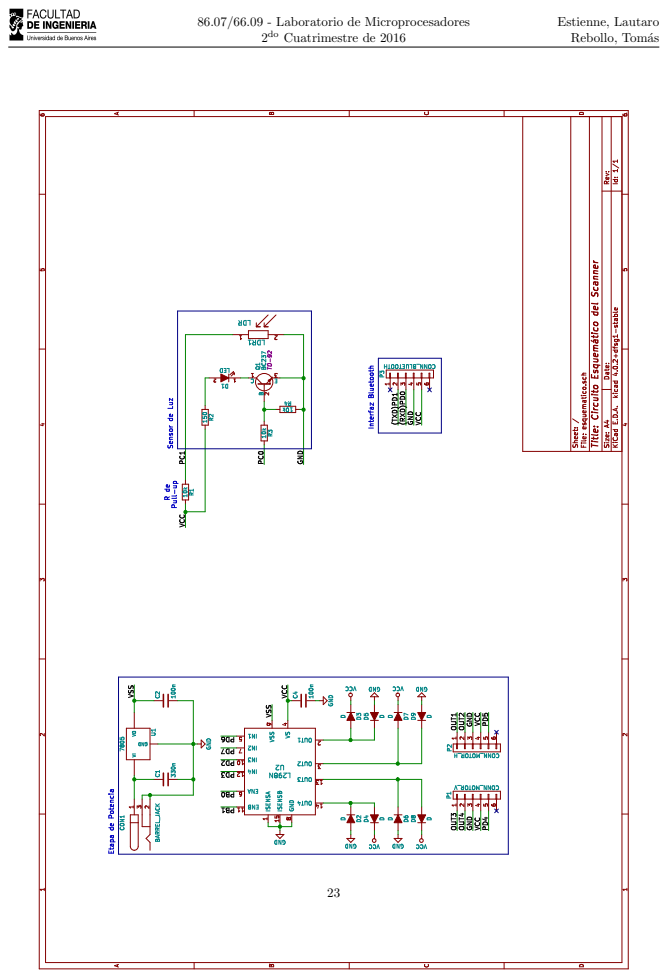
[picture p7: page 24]
