LautaroEst/2016_2c_trabajo_practico-lector_de_qr/doc/informe/main.pdf

# Facultad de Ingeniería - UBA Departamento de Electrónica 86.07/66.09 - Laboratorio de Microprocesadores

# Escaneo y Decodificación de Códigos QR


Profesor: | Ing. Guillermo Campiglio
Cuatrimestre/Año: | 2º/2016
Turno de las clases prácticas | Miércoles
Jefe de trabajos prácticos: | Ing. Ricardo Arias
Autores | Seguimiento del proyecto
Nombre | Apellido | Padrón
Lautaro | Estienne | 96671
Tomás | Rebollo | 90986

# Observaciones:

Fecha de aprobación | Firma J.T.P

# Coloquio Nota final Firma profesor

# 86.07/66.09 - Laboratorio de Microprocesadores do Cuatrimestre de 2016

# Estienne, Lautaro Rebollo, Tomás

# Resumen

En el presente trabajo, se construyó y programó un dispositivo capaz de escanear un código QR impreso en una hoja de papel, decodificarlo y enviar el mensaje contenido en él a un dispositivo celular. A su vez, el mismo fue diseñado para que el control de encendido y apagado del escaneo y el envío del mensaje sean controlados por Bluetooth.

# 1. Breve Introducción

Un código QR (Quick Response code, “código de respuesta rápida”) es un módulo para almacenar información

# en una matriz de puntos, que se utiliza hoy en día en distintas formas:

Registro de repuestos en el área de la fabricación de vehículos (primera implementación de estos códigos)

# Administración de inventarios en una gran variedad de industrias

# Almacenamiento de direcciones de páginas WEB en publicidades y anuncios

# Venta de productos y marketing de fidelización (como por ejemplo, cupones o descuentos)

# Etiquetado de productos en la tienda (como un código de barras)

La información que contiene un código QR puede incluír caracteres ACII, Kanji, o combinaciones de ambos, y además de los caracteres codificados, la matriz contiene una serie de puntos que dan información acerca de cómo está almacenado el mensaje en el código.


# Figura 1: Disposición de la información en la matriz QR

La decodificación del código consiste básicamente en dos pasos: leer y decodificar la información auxiliar de código para entender cómo está dispuesta la información, y luego leer la matriz en la forma en que está dispuesto el código (respetando la información obtenida anteriormente). En la figura 1 se muestra un código QR con el mensaje “www.wikipedia.org”, y en el mismo puede observarse qué parte del la matriz contiene la información del mensaje y qué parte contiene la información auxiliar (format info).

1

# 2. Objetivos propuestos

La idea original del proyecto fue armar un dispositivo que permitiera escanear una matriz cuadrada de puntos blancos y negros impresa en una hoja de papel, obteniendo como resultado de este escaneo un conjunto de bytes en memoria SRAM que representen los puntos de dicha matriz. (Es decir, si la matriz es un conjunto de puntos blancos y negros, entonces puede representarse como una serie de unos y ceros y almacenarse en una memoria.) Una vez leído el código, se propuso realizar un programa que reciba la dirección de memoria en que está guardada la matriz y decodifique el mensaje, almacenando en otra posición de memoria únicamente la sucesión de caracteres ASCII que componen el mensaje del código. Debe mencionarse que este paso considera uno solo de todos los métodos de lectura con el que se puede realizar la decodificación del QR (por supuesto, aquel que considera que en mensaje

# sólo contiene ASCII. Ver [4].)

Finalmente se propuso que, tanto el control de encendido y apagado del dispositivo escaneador como el envío del mensaje decodificado, sea manejado por un dispositivo móvil vía bluetooth. En este proceso, la lectura sería iniciada por la recepción de una orden enviada desde el celular y se realizaría en forma automática hasta finalizar el dibujo de la matriz. Una vez ahí, sería posible indicarle al scanner que envíe el mensaje al celular.

# 3. Objetivos logrados

Debido a los tiempos manejados y a los contratiempos (especialmente mecánicos) encontrados, el proyecto final terminó no siendo lo esperado en un principio, pero si se acercó mucho a lo que se deseaba.
El proyecto entregado realizaba automáticamente casi todas las funciones esperadas, menos el desplazado vertical del sensor para leer las filas de la matriz en forma continua. En lugar de ello, se decidió realizar una calibración manual (controlada por bluetooth) al finalizar cada fila. La misma consistió en controlar los motores que manejan el desplazamiento vertical de la hoja con dos nuevos botones en la aplicación móvil desarrollada para el proyecto. El problema principal que se presentó fue que el control de motores para lograr precisión en el desplazado requería de más horas de trabajo y pruebas para poder calibrar la funcionalidad. Además, la estructura del dispositivo para mantener la hoja centrada y fijada era un poco endeble, lo cual terminaba provocando que los desplazamientos verticales fueran siempre distintos, no pudiendo normalizarlo a una sola medida.
Por otra parte, fue posible realizar el escaneo para un solo tamaño del código, ya que la distinción entre puntos blancos y negros implicaba tener conocimiento previo del ancho de cada punto. Esto se hizo a modo de simplificación y con el objetivo de acotar la complejidad del programa y las posibles fallas.
Todo lo demás funcionó de acuerdo a lo pensado y establecido.

# 4. Descripción del Hardware

En la figura 2 se muestra el diagrama en bloques del scanner en su totalidad.
El circuito contiene una placa Arduino UNO, la cual utiliza un microcontrolador Atmega328P, que fue el implementado en este trabajo. En principio, la elección de este microcontrolador se debe fundamentalmente a la cantidad de memoria Flash y SRAM disponible, y esto es consecuencia de la gran dimensión de código que se necesitó para programar la decodificación del QR y la memoria necesaria para almacenar la matriz. Sin embargo, al finalizar el trabajo, puede comprobarse que si fuera por un tema de memoria, otros microcontroladores como el Atmega168 o el Atmega328 también habrían servido. Ahora bien, en el trabajo se utilizó la instrucción jmp para salto incondicional (debido nuevamente a la extensión del código) y esa instrucción sólo está permitida en el Atmega328P o en el Atmega168PA.
Por otro lado, se tiene el sensor de luz. El mismo fue construído específicamente para el trabajo y consiste en un circuito como el que se muestra en el esquemático del apéndice. En éste, se muestra un fotoresistor de Cadmio que varía su valor con la luz. De esta forma se obtiene una señal analogica que entra a uno de los puertos del micro y se determina a partir de ella si el color que se está leyendo es blanco o negro. Para que el contraste entre un color y el otro sea mayor, se utilizó una tira de LEDs del otro lado del papel, de manera que llegue más luz a este último.

2

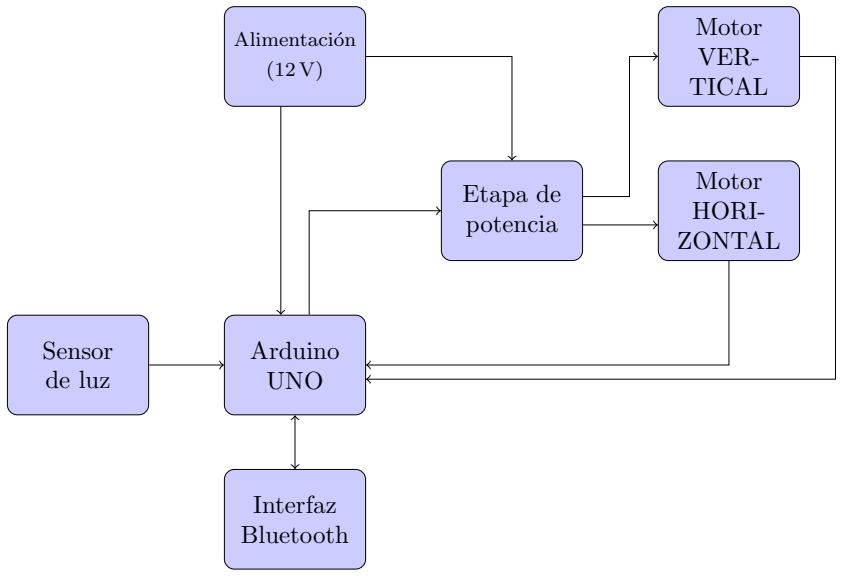
[picture p8: figure]
Alimentación; Motor VER- TICAL; Etapa de potencia; Motor HORI- ZONTAL; Sensor de luz; Arduino UNO; Interfaz Bluetooth

Figura 2: Diagrama en bloques del circuito completo.

Esta parte del trabajo fue, sin duda, la más crítica, ya que se debió preparar al equipo para que el escaneo soporte la resolución del código. Luego de varias pruebas se logró un resultado satisfactorio, con lo cual se concluyó que este sensor de fácil implementación sería suficiente para cubrir los objetivos del trabajo práctico.
Continuando con el circuito, se llega a la etapa de potencia utilizada para controlar los dos servo motores que controlan el escaneo. Estos motores funcionan correctamente con una tensión de 9 V, por lo que fue necesario adaptar la salida del microcontrolador con un puente-H doble (ya que se tienen dos motores). Para ello se eligió el integrado L298, uno de los más comunes para esta tarea. El circuito de esta etapa no comprende demasiadas complicaciones y se muestra en el apéndice del informe. Sí es posible agregar, sin embargo, que estos motores se comunican mendiante 6 conectores, descritos a continuación. Los primeros dos son la salida del puente-H: el motor avanza al aplicarle tensión positiva y retrocede con una tensión negativa; cuando no hay tensión, el motor se encuetra quieto. Existen por otro lado, otros dos pines destinados a la tensión de referencia del motor (VCC y GND). Finalmente, el motor cuenta con un encoder de dos terminales, el cual permite medir la velocidad con la que se mueve y la dirección en la que avanza. Para el trabajo sólo fue necesario uno de ellos, ya que sólo se midió la posición.
Por último, la interfaz del bluetooth no presenta mayores complicaciones, ya que el módulo utilizado (el HC-05 configurable como maestro-esclavo) tiene dos pines para la comunicación por puerto serie, y otros dos para la alimentación.
La construcción del dispositivo que permite sostener los motores, el sensor y el resto del circuito fue realizada mediante el equipo Mindstorms NXT 2.0 desarrollado por la empresa LEGO en 2006. El mismo viene equipado con los motores mencionados anteriormente y con todas las piezas necesarias para el armado del proyecto, excluyendo por supuesto, los componentes del circuito. La mayor parte de la información del funcionamiento de los motores fue obtenida de Wikipedia (ver referencia [6]) y de los diversos tutoriales encontrados en la web y dirigidos por personas que ya descubrieron el funcionamiento interno de los componentes.

# 5. Descripción del Software

# El código se encuentra dividido en 7 grandes bloques, a saber:

3

Inicialización y configuraciones: Dentro de este módulo se realizan todas las inicializaciones de variables y configuraciones a utilizar. Se utilizaron flags de estado y registros redefinidos con otros nombres para llevar

# más fácilmente el seguimiento del código. Las configuraciones realizadas fueron:

- Configuración de puertos como entradas y salidas.
- Configuración del ADC interno del microcontrolador.
- Configuración de timers como contadores.
- Configuración de USART como receptor de datos (el envío desde el microcontrolador será inicializado solo al momento en que se requiera enviar datos).
Una vez finalizadas las configuraciones, se realiza la primera lectura del ADC para saber en donde se encuentra actualmente el sensor.

Recepción Bluetooth: El programa quedará esperando la recepción de datos para iniciar el proceso de lectura. Se desarrolló una aplicación móvil que envía el caracter ASCII ’1’ para indicar el encendido de los motores, mientras que para desplazar la hoja verticalmente, utiliza ’+’ y ’-’.
Una vez recibido el caracter ’1’, se llama a la rutina ”leer columna”la cual se encarga de desplazar el motor horizontal para leer una línea del QR.

Movimiento de Motores: El dispositivo cuenta con dos motores, uno para realizar el barrido horizontal y leer cada columna de cuadrados, y otro para desplazar la hoja a la siguiente columna. El motor horizontal se maneja seteando los pines 6, 7 del puerto D y 0 del puerto B para retroceso o avance, y un bit de stop general respectivamente. El motor vertical se maneja con los pines 2, 3 del puerto D, y 1 del puerto B. Seteando o limpiando estos bits es como se manejaron los puentes H que terminaron controlando el desplazamiento de motores. Cada motor a su vez, enviaba al microcontrolador una señal de clock mientras estuviera funcionando, para llevar un control de su desplazamiento. Esto se contabilizó utilizando los timers para lograr precisión en la lectura.

Conteo de eventos: Los enconders de los motores fueron conectados a los pines 4 y 5 del puerto D, utilizados como contadores. Los timers 0 y 1 fueron configurados en modo CTC (clear timer on compare), con clock externo en T0 y T1 respectivamente. Ambos conteos se compararon contra dos umbrales para tener dimensión de cuando se avanzaba una unidad de lo que se quería medir. Esto fue medido y seteado a partir de los valores obtenidos.

Conversión analógico digital: Se utilizaron una fotorresistencia y una tira de leds por debajo de la hoja para lograr dos umbrales de tensión bien diferenciados para cada estado (blanco y negro). A partir de esto, se midió el voltaje con el ADC para saber en que color se encontraba el sensor.
El principal problema que se encontró en la conversión, es que no se podía definir con absoluta precisión la longitud de cada cuadrado del código para saber que valor correspondía a cada instante. Para eso, se estableció una medida aproximada y se contabilizó cuanto avanzaba el carro en el mismo color, seteando un flag cada vez que este cambiaba. Así, se realizaba una división que terminaba por dar la cantidad de cuadrados leídos de cada color.
El siguiente paso fue almacenar estos valores en registros para proceder a la decodificación correspondiente de cada línea. Para eso, se utilizaron los registros R20, R21 Y R22, llenados en el orden respectivo.
Una vez finalizada cada columna, se llamaba al método ’desenmascarar’ el cual procedía a aplicar la máscara seteada por defecto y posteriormente decodificar.

Decodificación: Fueron utilizados 6 acumuladores (ACUM0, ACUM1, ACUM2, ACUM3, ACUM 4 y ACUM5) para almacenar los bits leidos en el orden decodificado correspondiente.
La decodificación fue realizada bit a bit, rolleando cada registro al carry y dependiendo de su valor y la posición del mismo, seteando bits en los acumuladores. Cabe aclarar que el código QR tiene una estructura no cien por ciento homogénea, por lo cual dependiendo de la columna que se estaba leyendo, la forma de lectura y decodificado era distinta. Para las primeras 8 columnas, dos acumuladores se llenaron cada dos columnas (ACUM1 y ACUM2), mientras que otros (los ubicados horizontalmente, ACUM 0 Y ACUM3), se llenaron

4

cada 4. Mientras que para las restantes, fueron llenados cada dos columnas (ACUM1, ACUM2, ACUM3 y ACUM4), y cada 4 (ACUM0 y ACUM5).
Finalmente, a medida que cada acumulador era completamente llenado, se volcaba su valor en una tabla de memoria RAM en el orden correspondiente de lectura para que al finalizar, solo alcanzara con recorrer esta tabla. Para saber donde finalizaba, al terminar la lectura se agregó el caracter ’/’.
Si bien la estructura del código obligaba a un engorroso proceso de decodificado bit a bit, se pudo reutili-zar bastante código ya que al final de cuentas, eran 4 maneras distintas de recorrer los registros donde se almacenó la lectura inicial.

Envío Bluetooth: Para finalizar, se configuró al microcontrolador para enviar datos por puerto serie utilizando la interrupción de vaciado del UDRE0. A medida que se cargaban los datos, eran enviados y su valor limpiado, por lo cual la interrupción volvía a ejecutarse. A medida que esto ocurría, se incrementa-ban los punteros de la tabla para ir enviando letra a letra al dispositivo móvil. Una vez llegado al final, se inhabilitó nuevamente esta funcionalidad ya que sino queda enviando datos produciendo errores.

# Las interrupciones utilizadas fueron:

OC1Aaddr: Interrupción asociada al timer 1.

OC0Aaddr: Interrupción asociada al timer 0.

ADCCAddr: Interrupción asociada a la conversión analógica digital.

URXCAddr: Interrupción asociada a la recepción de datos por USART.

UDREAddr: Interrupción asociada al vaciado del UDRE0 para envío de datos.

# 6. Conclusiones y posibles mejoras

# Conclusiones:

El objetivo principal del proyecto se cumplió con éxito, y el dispositivo puede recibir, bajo ciertas limitaciones, una matriz QR impresa en una hoja de papel, guardar su contenido en la memoria del microcontrolador, procesarlo y enviar el mensaje que contiene el código a un dispositivo celular que tenga conexión por bluetooth y la aplicación adecuada. En este sentido, puede decirse que el trabajo realizado resultó muy satisfactorio, y que el objetivo de fondo que contiene la implementación de un trabajo de esta magnitud (el cual fue aprender a utilizar correctamente las herramientas del microprocesador) también se realizó con éxito.

Junto con la programación necesaria para utilizar las herramientas del micro, también se realizaron diversas tareas de hardware que permitieron ampliar nuestros conocimientos sobre la electrónica.

Luego de finalizar el proyecto, pudimos tomar noción de qué tan importante es la planificación y el conocimiento de lo que se va a hacer y cómo, ya que esto permite saber cuánto tiempo insumir en cada tarea y darle margen a los errores que se presentarán para poder resolverlos. Además, se entendió que existe la posibilidad de que una mala decisión al principio, afecte el desarrollo del proyecto, produciendo así que los tiempos no alcancen y no se logre cumplir el objetivo. El trabajo en equipo y la división de tareas al inicio fue fundamental para ir avanzando, ya que nos resultaba muy difícil juntarnos con frecuencia. Así, cada uno avanzó en las tareas correspondientes, logrando que los tiempos alcanzaran al final del cuatrimestre.

5

# Posibles mejoras a realizar:

La mejora fundamental que podría realizarse es la de automatizar completamente el proceso de lectura, logrando que el motor vertical dé pequeños saltos de manera constante sin desplazarse por demás o mover la hoja. Para ello, debería comprobarse su comportamiento con un motor paso a paso en lugar del utilizado. Además, podría implementarse la técnica del PWM para avanzar el motor horizontal. Este método no se consideró en los planes originales ya que, en un principio, la acción del motor para recorrer una fila se limita a avanzar el motor con una única velocidad. Además, utilizar este método hace que sea mucho más complejo el proceso de identificación de cada punto.

Consideramos que sea posible mejorar la parte del programa que se encarga de la decodificación implementando una forma de almacenamiento por filas y un código hecho en C. Esto facilitaría la programación y daría la posiblidad de utilizar diferentes tipos de lectura, pero con la desventaja de que sería necesario más memoria para contener el código y las filas escaneados. Debe mencionarse que utilizar Assembler para la decodificación, siempre implica analizar bit a bit la situación, por lo cual no es posible reemplazarlo por algo que no sea engorroso de programar.

El circuito que controlaba los motores y la tira de leds podría ser reemplazado por algo más pequeño y que realice un menor consumo de energía, ya que notamos que el regulador de tensión aumentaba bastante su temperatura, teniendo que apagar el dispositivo cada vez que se terminaba de utilizar o colocando un disipador.

Otra cosa que se podría mejorar, es un algoritmo de control para saber cuándo es necesario realizar nuevamente la lectura de datos.

# 7. Código

1
2 | ; ∗ ∗ ∗ ∗ ∗ ∗ ∗ ∗ ∗ ∗ ∗ ∗ ∗ ∗ ∗ ∗ ∗ ∗ ∗ ∗ ∗ ∗ ∗ ∗ ∗ ∗ ∗ ∗ ∗ ∗ ∗ ∗ ∗ ∗ ∗ ∗ ∗ ∗ ∗ ∗ ∗ ∗ ∗ ∗ ∗ ∗ ∗ ∗ ∗ ∗ ∗ ∗ ∗ ∗ ∗ ∗ ∗ ∗ ∗ ∗ ∗ ∗ ∗ ∗;
3 | ; PROYECTO FINAL : ESCANEO, DECODIFICACIOŃ Y ENVÍO DE UN CO´DIGO QR
4 | ; ∗ ∗ ∗ ∗ ∗ ∗ ∗ ∗ ∗ ∗ ∗ ∗ ∗ ∗ ∗ ∗ ∗ ∗ ∗ ∗ ∗ ∗ ∗ ∗ ∗ ∗ ∗ ∗ ∗ ∗ ∗ ∗ ∗ ∗ ∗ ∗ ∗ ∗ ∗ ∗ ∗ ∗ ∗ ∗ ∗ ∗ ∗ ∗ ∗ ∗ ∗ ∗ ∗ ∗ ∗ ∗ ∗ ∗ ∗ ∗ ∗ ∗ ∗ ∗;
5
6
7
8
9 | ; ∗ ∗ ∗ ∗ ∗ ∗ ∗ ∗ ∗ ∗ ∗ ∗ ∗ ∗ ∗ ∗ ∗ ∗ ∗ ∗ ∗ ∗ ∗ ∗ ∗ ∗ ∗ ∗ ∗ ∗ ∗ ∗ ∗ ∗ ∗ ∗ ∗ ∗ ∗ ∗ ∗ ∗ ∗ ∗ ∗ ∗ ∗ ∗ ∗ ∗ ∗ ∗ ∗ ∗ ∗ ∗ ∗ ∗ ∗ ∗ ∗ ∗ ∗ ∗ ∗ ∗ ∗ ∗ ∗ ∗ ∗ ∗ ∗ ∗ ∗ ∗ ∗ ∗ ∗ ∗ ∗ ∗ ∗ ∗ ∗ ∗ ∗ ∗ ∗ ∗ ∗ ∗ ∗ ;
10 | ;BLOQUE DE DEFINICIONES
11
12 | . i n c l u d e | ” m 3 2 8P d e f . i n c ”
13 | . i n c l u d e | ” m a c r o s . i n c ”
14
15 | ; ; ; | SE DEFINE UN REGISTRO DE I /O, | ”SCANNER” , CON LOS FLAGS NECESARIOS PARA EL ESCANEO
16 | . e q u | SCANNER = GPIOR0
17 | . e q u | COLOR = 0 | ; | Negro=1 , B lanco=0
18 | . e q u | ESCANEANDO = 1 | ; | F lag pa ra | l a | c o n v e r s i ón d e l ADC
19 | . e q u | CAMBIO COLOR = 2 | ; | F lag pa ra | e l | c á l c u l o | de | l o s | b i t s | l e í do s
20 | . e q u | FIN COLUMNA = 3
21 | . e q u | AVANZO CASILLA = 4
22 | . e q u | FLAG BLUETOOTH = 5 | ; F l a g s | pa ra | l a | r e c e p c i ón po r | b l u e t o o t h
23 | . e q u | FLAG BLUETOOTH VACIO = 6
24
25 | ; ; ; | SE DEFINE UN REGISTRO, | ”MOTORES” , CON LOS FLAGS NECESARIOS PARA VIGILAR EL ESTADO DE LOS MOTORES
26 | . d e f | MOTORES = r 3 1
27 | . e q u | MOTOR H ENABLE = 0
28 | . e q u | MOTOR H STOP FLAG = 1
29 | . e q u | MOTOR H DIR = 2 | ; DIR=FORWARD=1 , DIR=REVERSE=0
30 | . e q u | MOTOR V ENABLE = 3
31 | . e q u | MOTOR V STOP FLAG = 4
32 | . e q u | MOTOR V DIR = 5
33
34 | ; ; ; REGISTROS Y CONSTANTES PERSONALIZADOS
35 | . e q u | LIMITE FLANCOS = 255 | ;Número de | f l a n c o s | que c o r r e s p o n d e n | a l | t iempo que
36 | ; t a r d a | e l | motor | H o r i z o n t a l | en | r e c o r r e r | e l | ancho de | l a pá g i n a
37 | . e q u | TAMANIO CASILLA = 13 | ;Número de | f l a n c o s | que c o r r e s p o n d e n | a l | l a r g o | de una | c a s i l l a
38 | . e q u | CORTE POR REDONDEO = TAMANIO CASILLA − 9
39 | . e q u | CANTIDAD FILAS = 21
40 | . e q u | CANTIDAD COLUMNAS = 21
41 | . e q u | ULTIMO BIT DE FILA = CANTIDAD COLUMNAS − 1
42 | . e q u | ULTIMO BIT DE COLUMNA = CANTIDAD FILAS − 1
43 | . e q u | BAUD RATE = 0 x67 | ; E s t e | e s | e l | v a l o r | que debe | p o n e r s e | pa ra | t e n e r un baud r a t e | de 9 6 0 0 , que | e s | e l | que u sa | e l | hc 05 .
44 | . e q u | CARACTER FIN = ’ / ’ | ; C a r a c t e r | con | e l | que t e rm i n a r á | e l | c ó d i g o QR
45 | . e q u | INICIO TABLA = 0 x0100
46

6

47 | . d e f | CERO = r 0 | ; R e g i s t r o s | u t i l i z a d o s | pa ra una p rueba de env í o
48 | . d e f | UNO = r 1
49 | . d e f | CANT = r 3 | ; Can t idad de | b i t s | l e í do s | d e l mismo c o l o r
50 | . d e f | SIZE = r 4 | ; R e g i s t r o | que gua rda | e l | tamaño de un b i t
51 | . d e f | SIZE 2 = r 5
52
53 | . d e f | rtemp1 = r 1 6 | ; R e g i s t r o s | a u x i l i a r e s
54 | . d e f | rtemp2 = r 1 7
55 | . d e f | BIT ACTUAL = r 1 8 | ; P o s i c i ón a c t u a l | d e l | motor en una co l um na .
56 | . d e f | POS INICIAL = r 8 | ; E s t o s | do s | r e g i s t r o s | s i r v e n | pa ra | c a l c u l a r | l a | c a n t i d a d de | b i t s | que | s e | l e y e r o n | d e l mismo c o l o r
57 | . d e f | POS FINAL = r 9
58
59 | ; ; ; REGISTROS PARA LA DECODIFICACIOŃ
60 | . d e f | CONT H = r 1 9 | ; Cuenta | l a | c a n t i d a d de co lumna s | l e í da s
61 | . d e f | CANT LETRAS LEIDAS = r 6 | ; Cuenta | l a | c a n t i d a d de | l e t r a s | d e c o d i f i c a d a s
62 | . d e f | LENGTH = r 7
63 | . d e f | ACUM1 = r 2 3 | ; La i d e a | de | e s t o s | a c um u la do r e s | e s | i r | s o s t e n i e n d o | l o s | v a l o r e s | ya p r o c e s a d o s , | que | l u e g o | s e | gua rdan en SRAM
64 | . d e f | ACUM2 = r 2 4
65 | . d e f | ACUM3 = r 2 5
66 | . d e f | ACUM4 = r 2 8
67 | . d e f | ACUM5 = r 2 9
68 | . d e f | ACUM6 = r 3 0
69
70 | . e q u | B7 = 0 x80
71 | . e q u | B6 = 0 x40
72 | . e q u | B5 = 0 x20
73 | . e q u | B4 = 0 x10
74 | . e q u | B3 = 0 x08
75 | . e q u | B2 = 0 x04
76 | . e q u | B1 = 0 x02
77 | . e q u | B0 = 0 x01
78
79 | ; ; ; | DEFINICIOŃ DE LOS PUERTOS
80 | . e q u | MOTOR H OUT1 PORT DIR = DDRD | ; Mo to re s HORIZONTAL y VERTICAL.
81 | . e q u | MOTOR H OUT1 PORT = PORTD | ; Cada motor | t i e n e | do s | p i n e s | (OUT1 y OUT2) que | c o n t r o l a n | l a
82 | . e q u | MOTOR H OUT1 PIN = 6 | ; su mov im iento :
83 | . e q u | MOTOR H OUT2 PORT DIR = DDRD | ; | f o rw a r d −−> OUT1=0 , OUTT2=1
84 | . e q u | MOTOR H OUT2 PORT = PORTD | ; | r e v e r s e −−> OUT1=1 , OUT2=0
85 | . e q u | MOTOR H OUT2 PIN = 7 | ; | s t o p | −−> OUT1=0 , OUT2=0
86 | . e q u | MOTOR H ENABLE PORT DIR = DDRB | ; Además , | cada motor | t i e n e un ENABLE que | h a b i l i t a | su | f u n c i o n am i e n t o .
87 | . e q u | MOTOR H ENABLE PORT = PORTB
88 | . e q u | MOTOR H ENABLE PIN = 0
89 | . e q u | MOTOR V OUT1 PORT DIR = DDRD
90 | . e q u | MOTOR V OUT1 PORT = PORTD
91 | . e q u | MOTOR V OUT1 PIN = 2
92 | . e q u | MOTOR V OUT2 PORT DIR = DDRD
93 | . e q u | MOTOR V OUT2 PORT = PORTD
94 | . e q u | MOTOR V OUT2 PIN = 3
95 | . e q u | MOTOR V ENABLE PORT DIR = DDRB
96 | . e q u | MOTOR V ENABLE PORT = PORTB
97 | . e q u | MOTOR V ENABLE PIN = 1
98
99 | . e q u | COUNTER0 PORT DIR = DDRD | ; C o n f i g u r a c i ón de | l o s | p u e r t o s | u t i l i z a d o s | como c o n t a d o r e s | e x t e r n o s ,
100 | . e q u | COUNTER0 PIN = 4 | ; c o n e c t a d o s a | l o s | e n c o d e r s | d e l | mo to r s
101 | . e q u | COUNTER1 PORT DIR = DDRD
102 | . e q u | COUNTER1 PIN = 5
103
104 | . e q u | SENSOR INPUT PORT DIR = DDRC | ; En t rada | a n a l ó g i c a | d e l | s e n s o r | de | l u z .
105 | . e q u | SENSOR INPUT PIN = 1
106
107 | . e q u | SENSOR LED PORT DIR = DDRC | ; Led que | v i e n e | con | e l | s e n s o r . No f u e | n e c e s a r i o | su | u t i l i z a c i ón ,
108 | . e q u | SENSOR LED PORT = PORTC | ; p e r o | s e | c o n f u g u r a | pa ra | m a n t e n e r l o | a p a g a d o .
109 | . e q u | SENSOR LED PIN = 0
110
111 | . e q u | LED PRUEBA PORT DIR = | DDRB | ; Led de prueba , | de | l a | p l a c a | de Ardu ino UNO.
112 | . e q u | LED PRUEBA PORT | = | PORTB
113 | . e q u | LED PRUEBA PIN | = | 5
114
115
116
117 | ; ∗ ∗ ∗ ∗ ∗ ∗ ∗ ∗ ∗ ∗ ∗ ∗ ∗ ∗ ∗ ∗ ∗ ∗ ∗ ∗ ∗ ∗ ∗ ∗ ∗ ∗ ∗ ∗ ∗ ∗ ∗ ∗ ∗ ∗ ∗ ∗ ∗ ∗ ∗ ∗ ∗ ∗ ∗ ∗ ∗ ∗ ∗ ∗ ∗ ∗ ∗ ∗ ∗ ∗ ∗ ∗ ∗ ∗ ∗ ∗ ∗ ∗ ∗ ∗ ∗ ∗ ∗ ∗ ∗ ∗ ∗ ∗ ∗ ∗ ∗ ∗ ∗ ∗ ∗ ∗ ∗ ∗ ∗ ∗ ∗ ∗ ∗ ∗ ∗ ∗ ∗ ∗ ∗ ;
118 | ;COMIENZO DEL PROGRAMA
119
120 | ; ; | Tab la de | i n t e r r u p c i o n e s
121 | . o r g 0 x0000
122 | rjmp | i n i c i o
123 | . o r g OC1Aaddr
124 | rjmp | c o u n t e r 1 i n t h a n d l e r
125 | . o r g OC0Aaddr
126 | rjmp | c o u n t e r 0 i n t h a n d l e r
127 | . o r g ADCCaddr
128 | rjmp | a d c i n t h a n d l e r
129 | . o r g URXCaddr
130 | rjmp | u r x i n t h a n d l e r | ; I n t e r r u p c i ón p r o d u c i d a | po r | l a | r e c e p c i ón de d a t o s
131 | . o r g UDREaddr
132 | rjmp | u d r e i n t h a n d l e r
133 | . o r g INT VECTORS SIZE
134
135
136 | i n i c i o :
137 | ; ; | C o n f i g u r a c i o n e s | v a r i a s | ( v e r | s e c c i ón ”FUNCIONES DE CONFIGURACIOŃ” )
138 | l d i | rtemp1 ,HIGH(RAMEND)
139 | ou t sph , rtemp1
140 | l d i | rtemp1 ,LOW(RAMEND)
141 | ou t | s p l , rtemp1
142 | r c a l l | c o n f i g u r a r p u e r t o s
143 | r c a l l | c o n f i g u r a r a d c
144 | r c a l l | c o n f i g u r a r c o n t a d o r e s

7

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

8

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

9

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

10

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

11

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

12

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

13

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

14

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

15

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

16

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

17

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

# Referencias

[1] Muhammad Ali Mazidi, Zarmad Naimi, Sepehr Naimi. The AVR Microcontroller and Embedded System Using Assembly and C. Prentice Hall.
[2] Atmel 8-bit Microcontroller 4/8/16/32Kbytes In-system Programmable Flash Datasheet.

# [3] Atmel AVR 8-bit Instruction Set Manual

# [4] https://en.wikipedia.org/wiki/QRcode

# [5] http://www.ams.org/samplings/feature-column/fc-2013-02

# [6] https://en.wikipedia.org/wiki/Lego_Mindstorms_NXT

# Apéndice

A continuación se muestran los esquemáticos de la placa de Arduino UNO y del circuito diseñado para la implementación del escaneo.

18

# Arduino UNO Reference Design

TM

Reference Designs ARE PROVIDED "AS IS" AND "WITH ALL FAULTS". Arduino DISCLAIMS ALL OTHER WARRANTIES, EXPRESS OR IMPLIED, Arduino may make changes to specifications and product descriptions at any time, without notice. The Customer must not REGARDING PRODUCTS, INCLUDING BUT NOT LIMITED TO, ANY IMPLIED WARRANTIES OF MERCHANTABILITY OR FITNESS FOR A PARTICULAR PURPOSE

rely on the absence or characteristics of any features or instructions marked "reserved" or "undefined." Arduino reserves

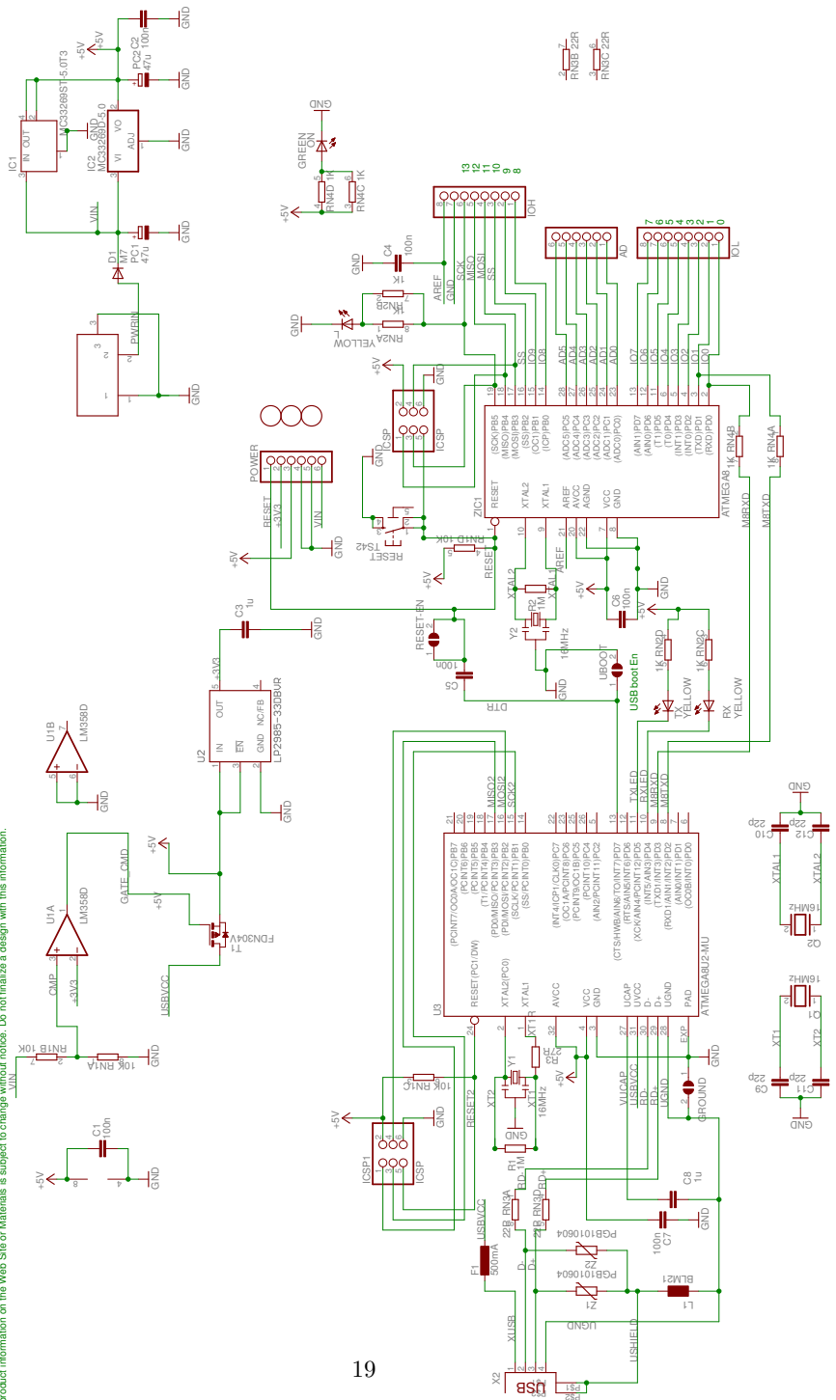
[picture p9: figure]
ATMEGA8; ICSP; +5V GND; GND; 100nGND 47u 47u GND GND; GND GREEN; YELLOW; M7 GND MC33269D-5.0 MC33269ST-5.0T3; 100n GND; GWOLLEY ND; +5V LM358D LM358D GND GND; ATMEGA8U2-MU; 16MHz 16MHz DNG; (ADC5)PC5; (ADC4)PC4; (ADC3)PC3; (ADC2)PC2; (ADC1)PC1; (ADC0)PC0) 23; (SCK)PB5; (MISO)PB4; (MOSI)PB3; (ICP)PB0; (AIN1)PD7; (AIN0)PD6; (INT1)PD3; (INT0)PD2; (TXD)PD1; (RXD)PD0; GND 8 VCC; 7 AVCC 20 AREF; 21 XTAL1; 9 XTAL2; 10 RESET; AGND; ZIC1; IOL; IOH; IC2 ADJ; 3 OUT; 6 POWER; (PCINT9/OC1B)PC5; (PCINT10)PC4; (INT4/ICP1/CLK0)PC7; (OC1A/PCINT8)PC6; (AIN2/PCINT11)PC2; (PCINT5)PB5; (T1/PCINT4)PB4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

these for future definition and shall have no responsibility whatsoever for conflicts or incompatibilities arising from future changes to them. The product information on the Web Site or Materials is subject to change without notice. Do not finalize a design with this information.

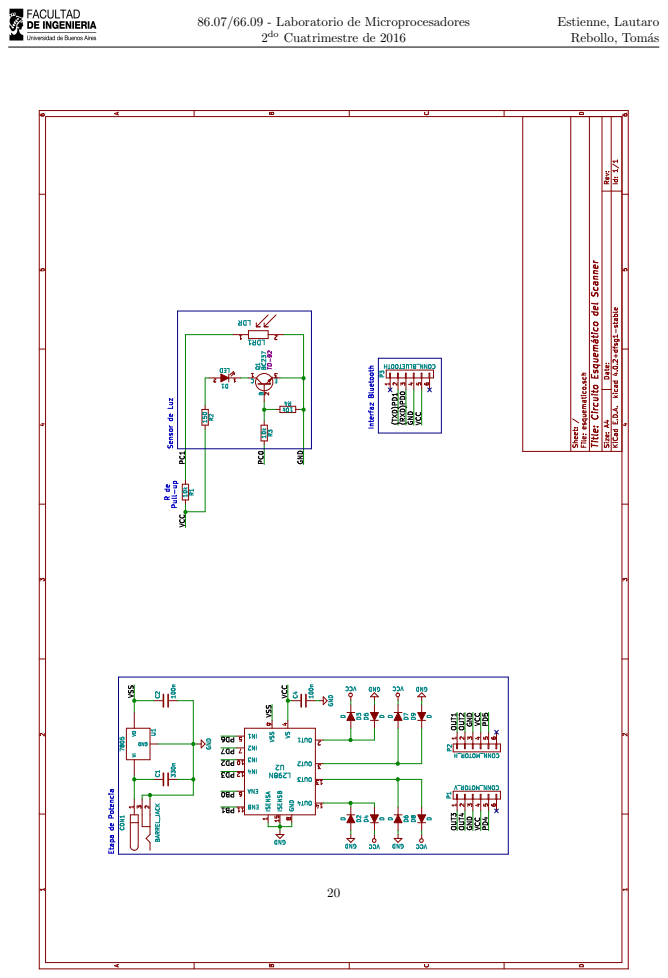
[picture p10: page 21]
