LautaroEst/2016_2c_trabajo_practico-lector_de_qr/(list of files, cad)

Other CAD files:
codigo/decodificacion_avr.obj
